ygonb/PIBEX/COBENGE/Imagens/Circuito 2.JPG

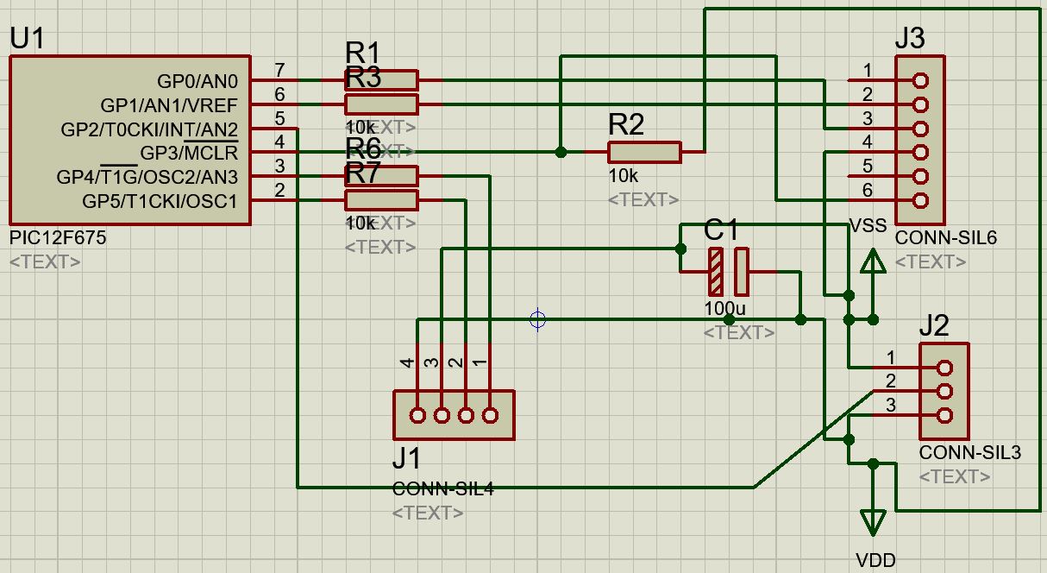
COBENGE/Imagens/Circuito 2.JPG
