ygonb/PIBEX/COBENGE/Imagens/IMG_20191106_175116710.jpg

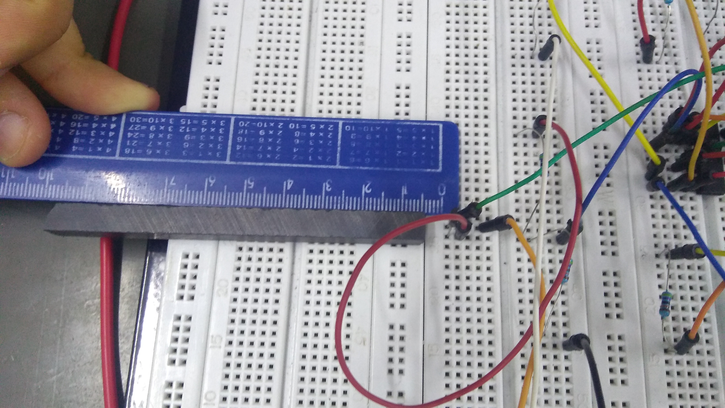
COBENGE/Imagens/IMG_20191106_175116710.jpg
