ygonb/PIBEX/README.md

# PIBEX
Projeto PIBEX 2019-2020

Este repositório contém os arquivos bla bla bla
