ygonb/PIBEX/Relatório Parcial/Vídeo/Decscartados/SLIDE APRESENTAÇÃO PARCIAL.pptx

## Título:


DESENVOLVIMENTO E AVALIAÇÃO DE KIT DIDÁTICO MODULAR PARA ENSINO DE FÍSICA EXPERIMENTAL NO ENSINO MÉDIO E SUPERIOR

Nomes do alunos (as): Pedro Henrique Dules de Lima e Lays Leal Correia

Orientador (a):Ygo Neto Batista

## A relevância e objetivo geral do projeto

- Irei aparecer aqui com o vídeo

## Objetivos propostos

- Irei aparecer aqui com o vídeo

## Slide 4
