ygonb/PIBEX/Relatório Final/Vídeo/autorização de imagem - Lays.pdf

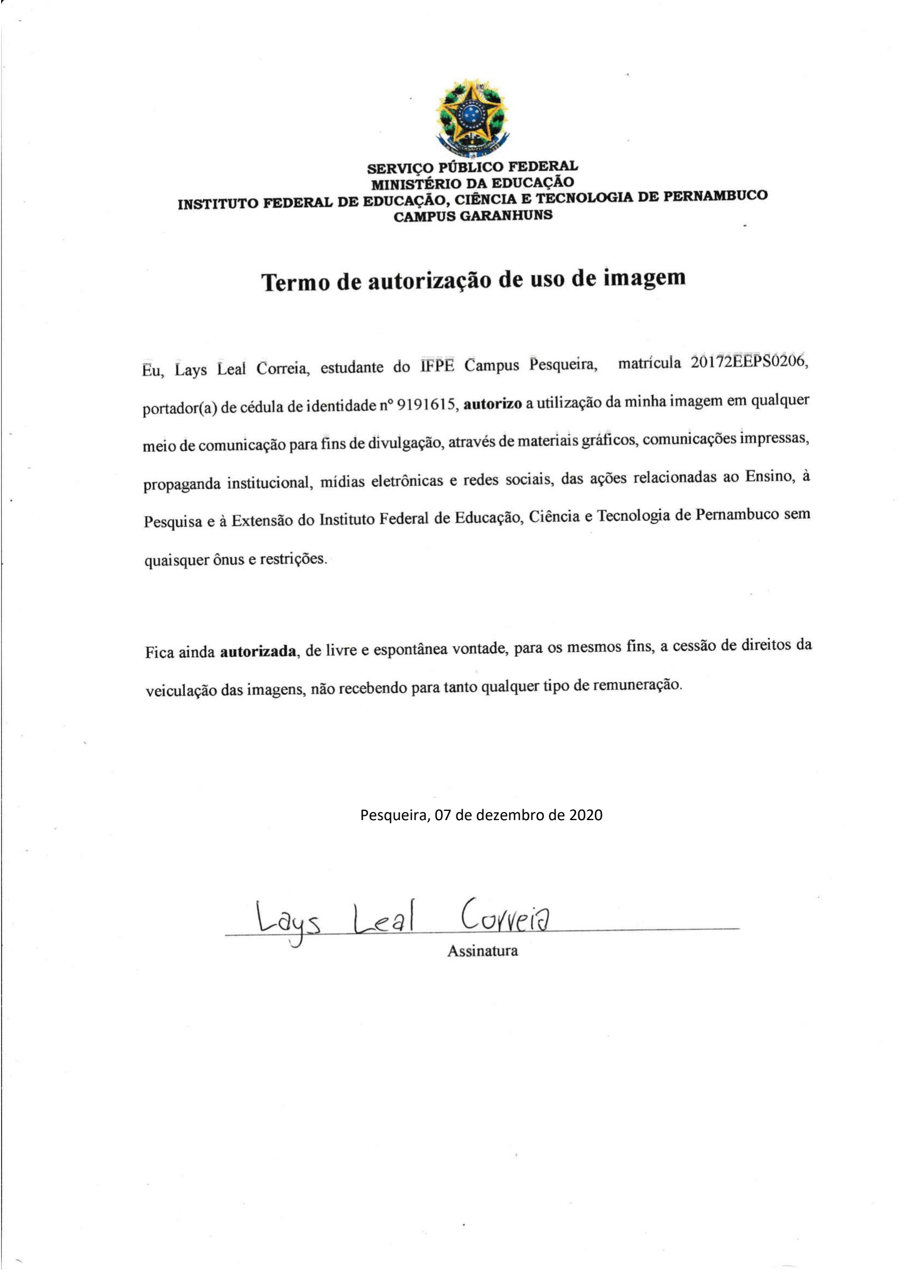
[picture p27: page 1]

Pesqueira, 07 de dezembro de 2020
