ygonb/PIBEX/Circuito Elétrico Inicial/Divisor de tensão.jpeg

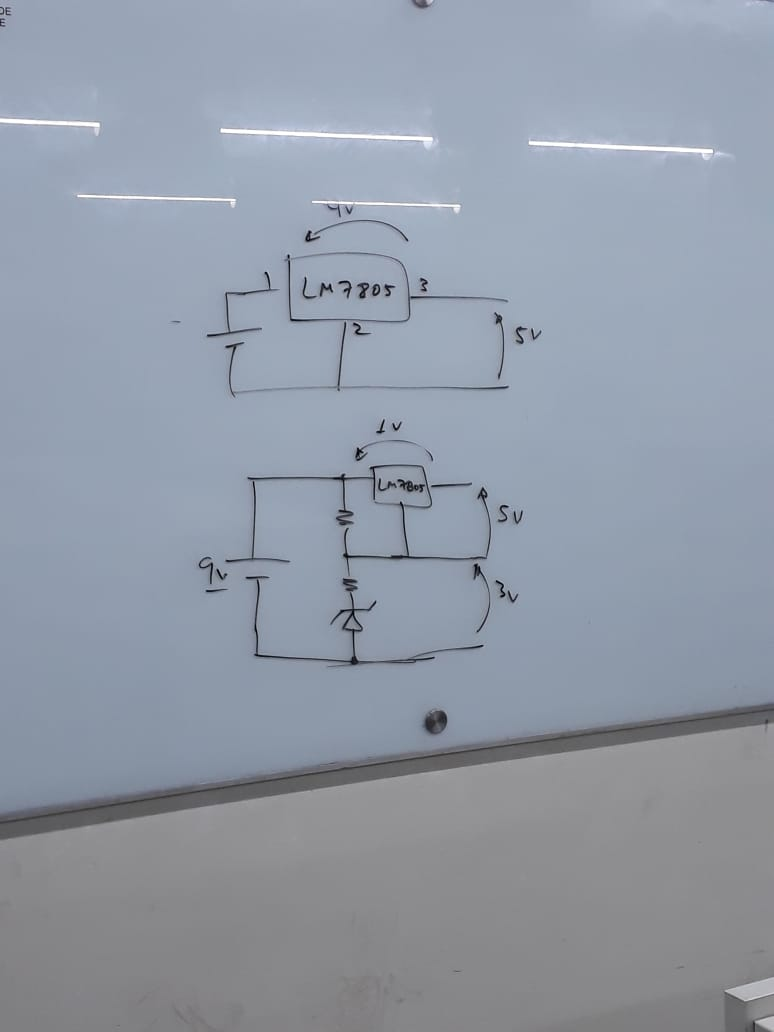
Circuito Elétrico Inicial/Divisor de tensão.jpeg
