ygonb/PIBEX/Circuito Elétrico Inicial/Esboço inicial.jpeg

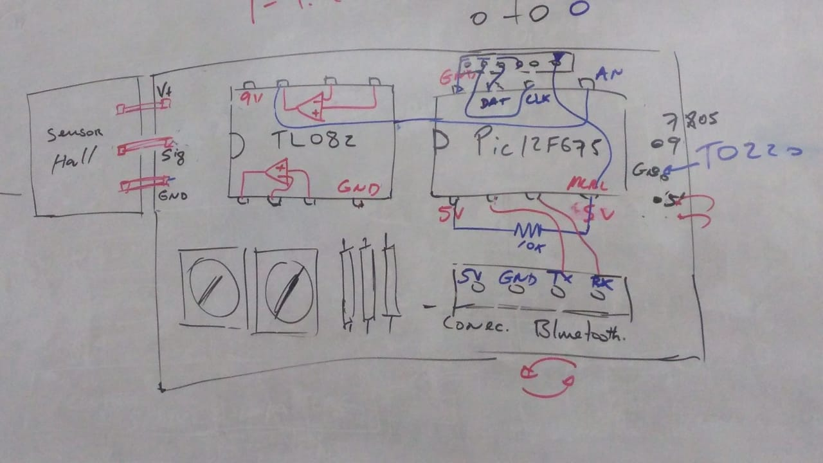
Circuito Elétrico Inicial/Esboço inicial.jpeg
