ygonb/PIBEX/COBENGE/Imagens/IMG_20191106_175142173.jpg

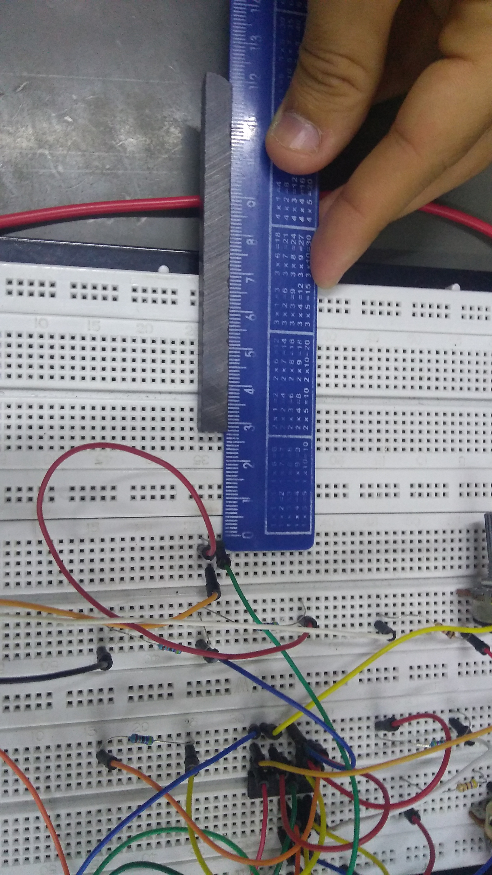
COBENGE/Imagens/IMG_20191106_175142173.jpg
