ygonb/PIBEX/COBENGE/Imagens/IMG_20191106_175145256.jpg

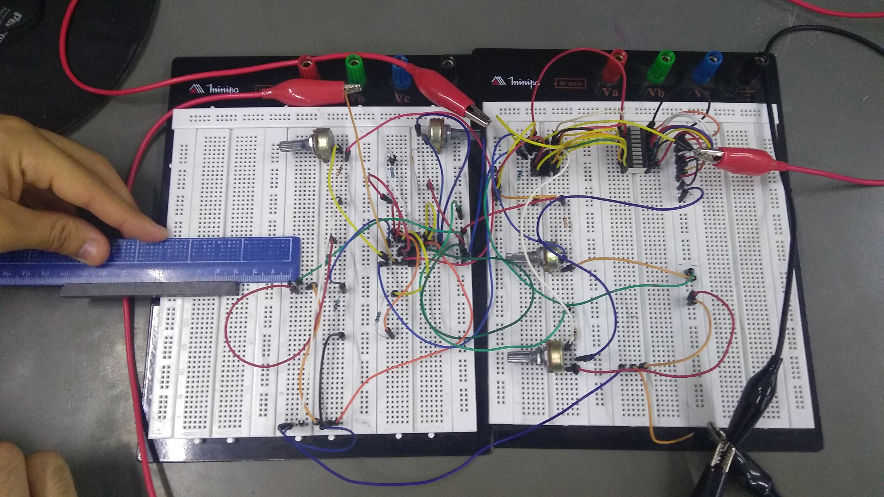
COBENGE/Imagens/IMG_20191106_175145256.jpg
