ygonb/PIBEX/COBENGE/Imagens/PCB 1.JPG

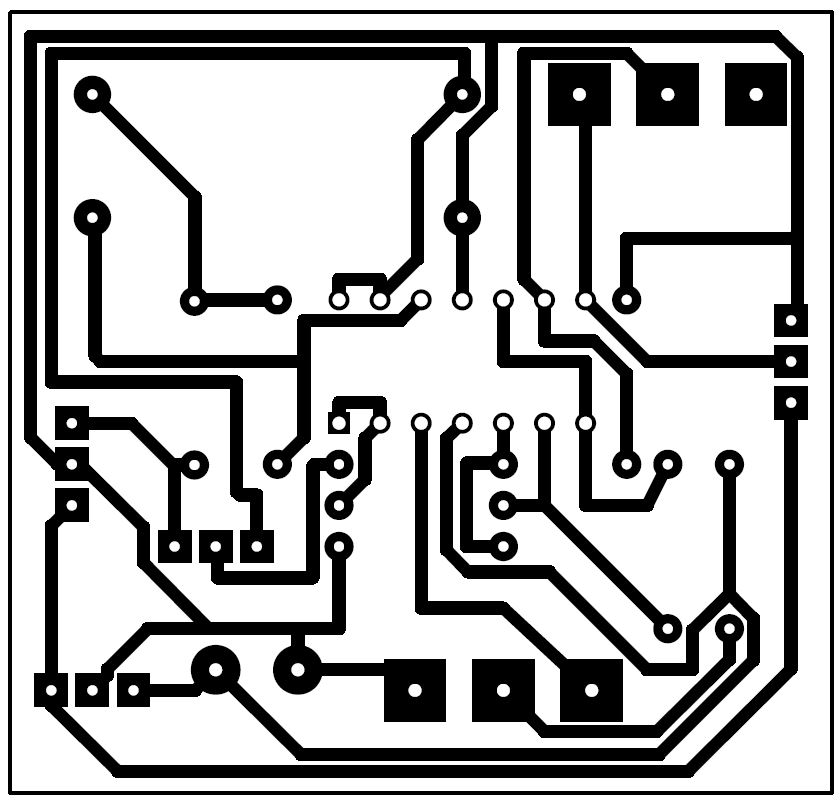
COBENGE/Imagens/PCB 1.JPG
