ygonb/PIBEX/COBENGE/Imagens/PCB 2.JPG

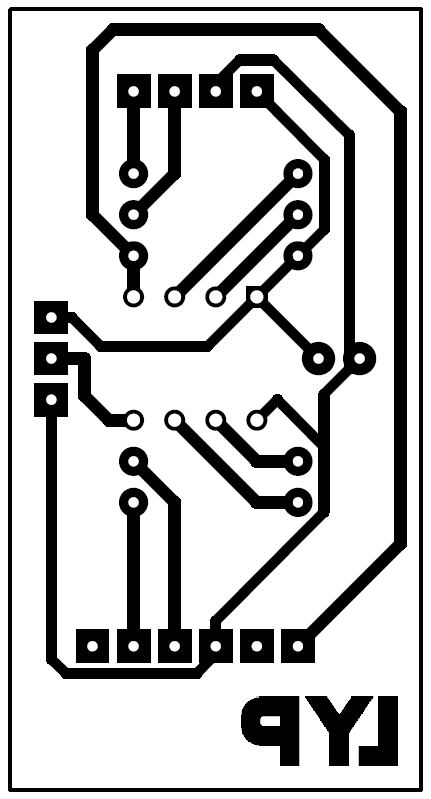
COBENGE/Imagens/PCB 2.JPG
