ygonb/PIBEX/Filtro passa baixa CM.jpeg

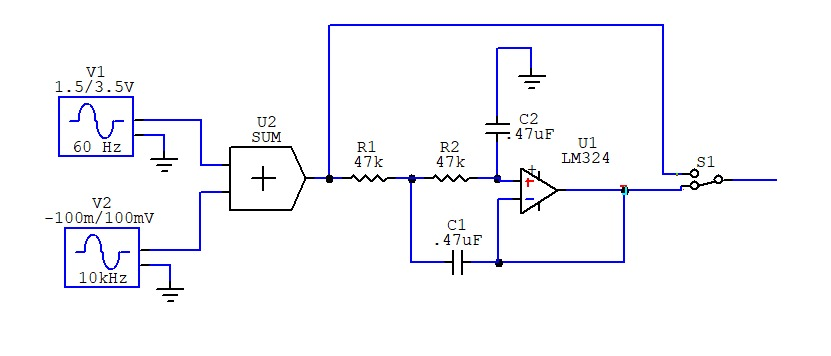
Filtro passa baixa CM.jpeg
