ygonb/PIBEX/Protoboard 1 - Projeto Original.JPG

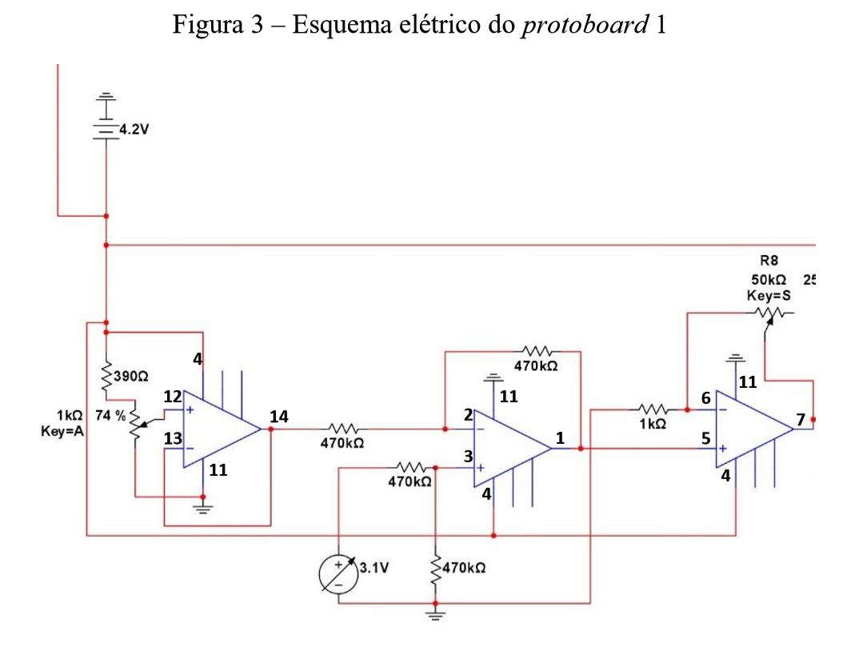
Protoboard 1 - Projeto Original.JPG
