ygonb/PIBEX/Relatório Final/Vídeo/capa.png

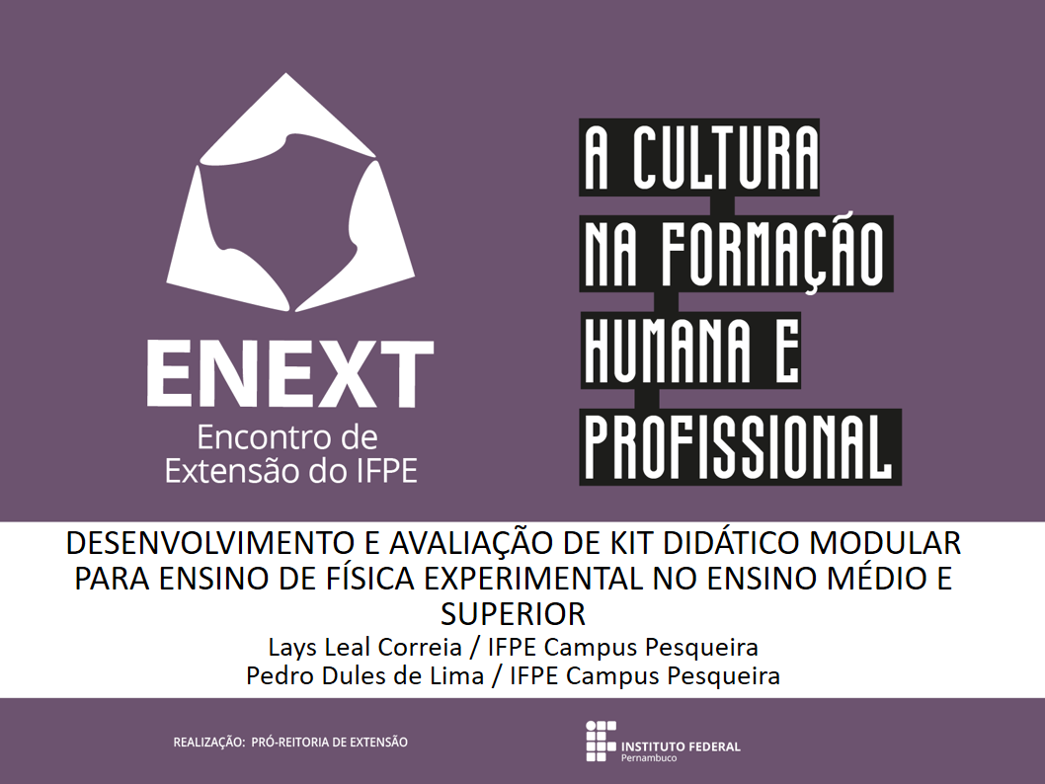
Relatório Final/Vídeo/capa.png
