ygonb/PIBEX/Relatório Final/Vídeo/Circuito Ultrassônico.png

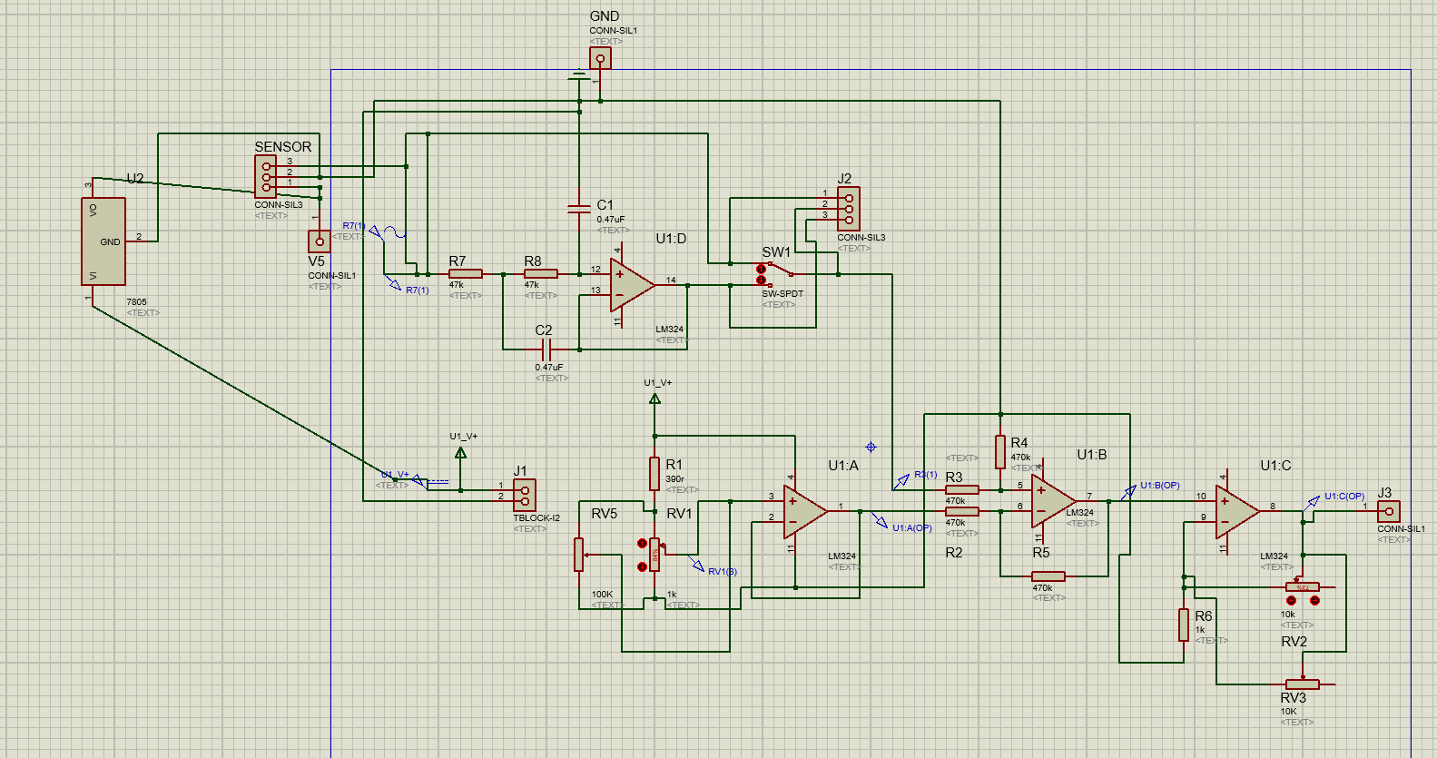
Relatório Final/Vídeo/Circuito Ultrassônico.png
