ygonb/PIBEX/Relatório Final/Vídeo/lives-projeção-enext.png

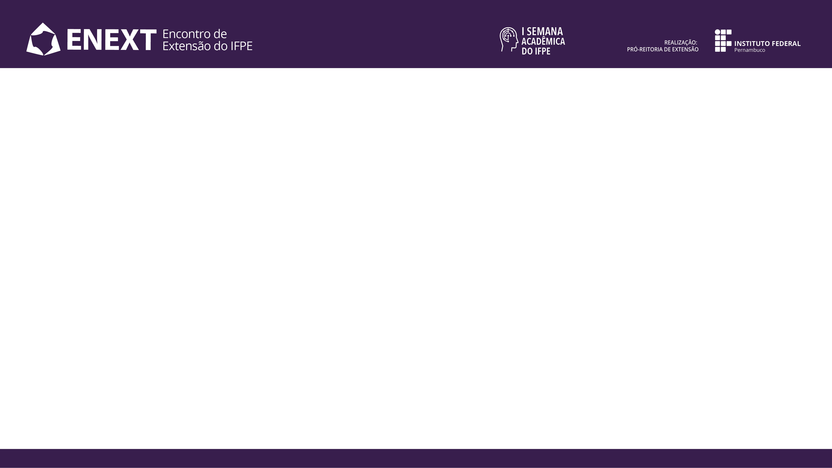
Relatório Final/Vídeo/lives-projeção-enext.png
