ygonb/PIBEX/Relatório Parcial/Vídeo/Slide Lays/Slide1.png

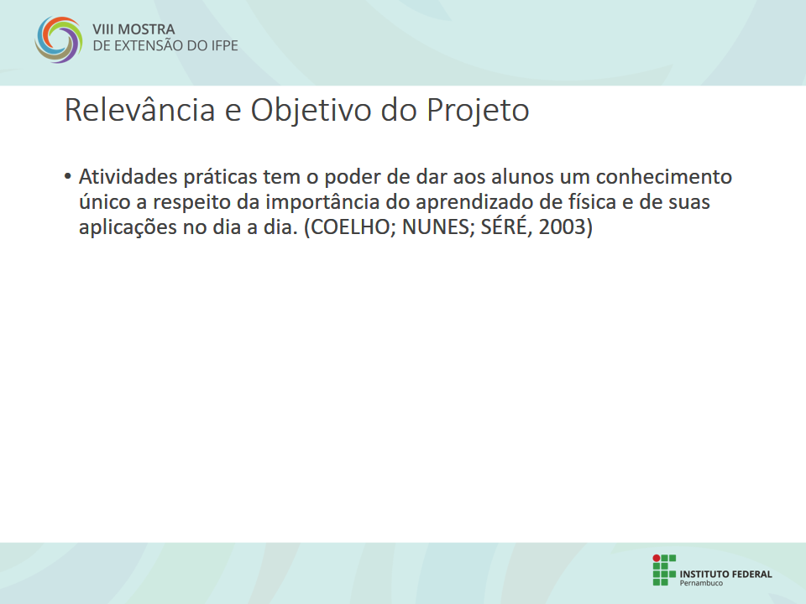
Relatório Parcial/Vídeo/Slide Lays/Slide1.png
