ygonb/PIBEX/Relatório Parcial/Vídeo/Slide Lays/Slide2.png

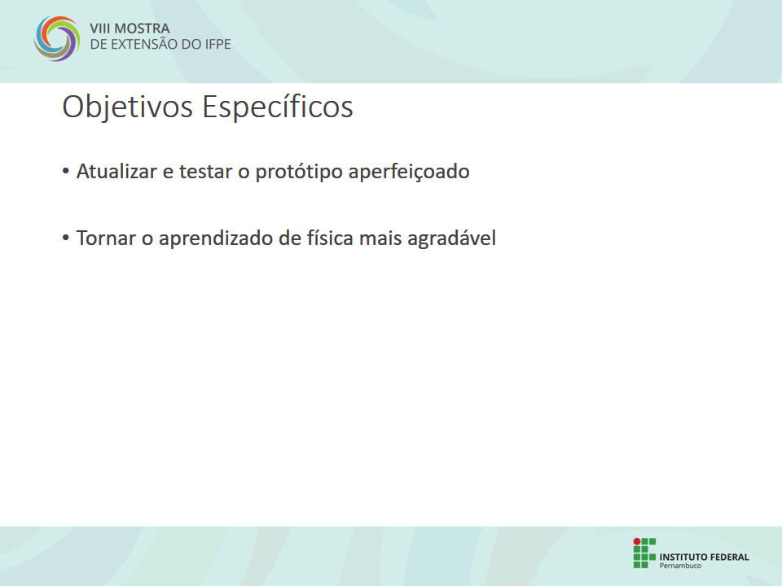
Relatório Parcial/Vídeo/Slide Lays/Slide2.png
