ygonb/PIBEX/Relatório Parcial/Vídeo/Slide Lays/Slide3.PNG

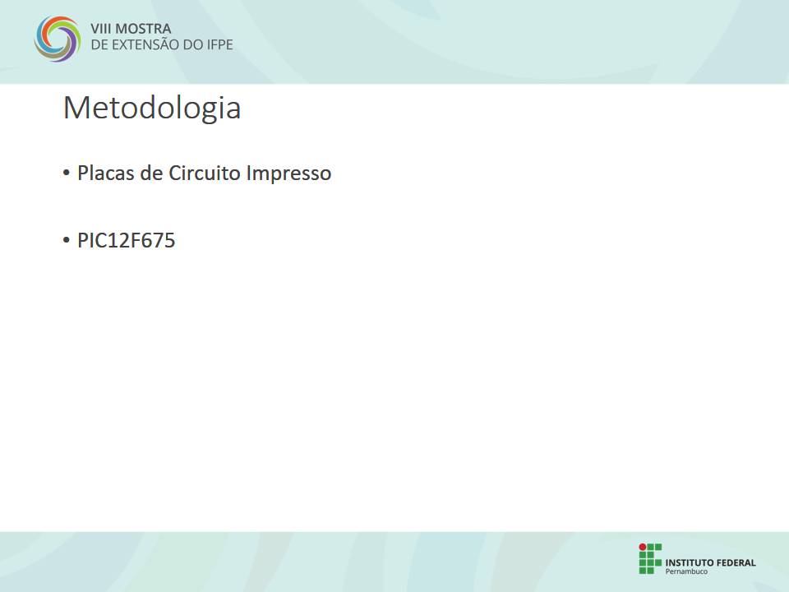
Relatório Parcial/Vídeo/Slide Lays/Slide3.PNG
