ygonb/PIBEX/Relatório Parcial/Vídeo/Slide Lays/Slide4.PNG

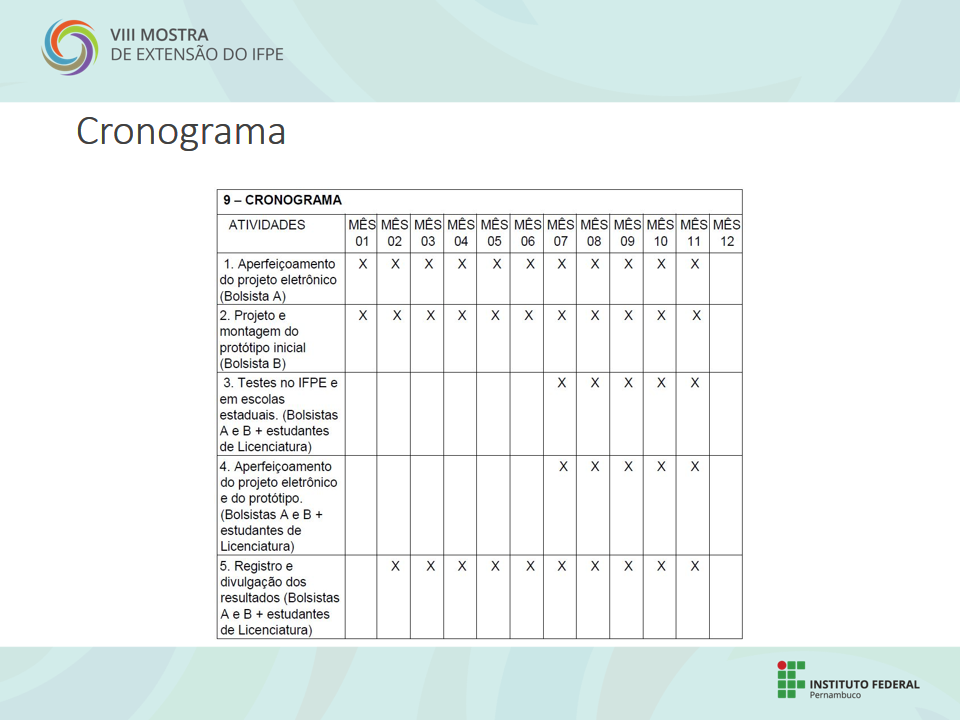
Relatório Parcial/Vídeo/Slide Lays/Slide4.PNG
