ygonb/PIBEX/Relatório Parcial/Vídeo/Slide Lays/Slide5.PNG

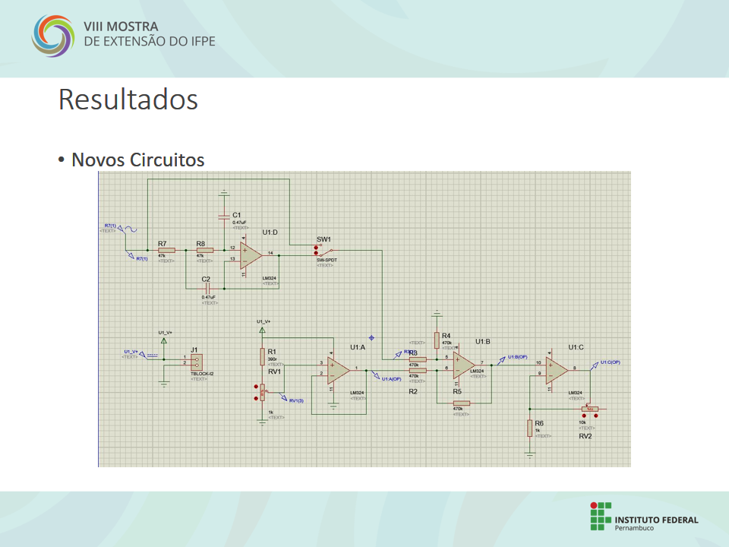
Relatório Parcial/Vídeo/Slide Lays/Slide5.PNG
