ygonb/PIBEX/Relatório Parcial/Vídeo/Slide Lays/Slide6.PNG

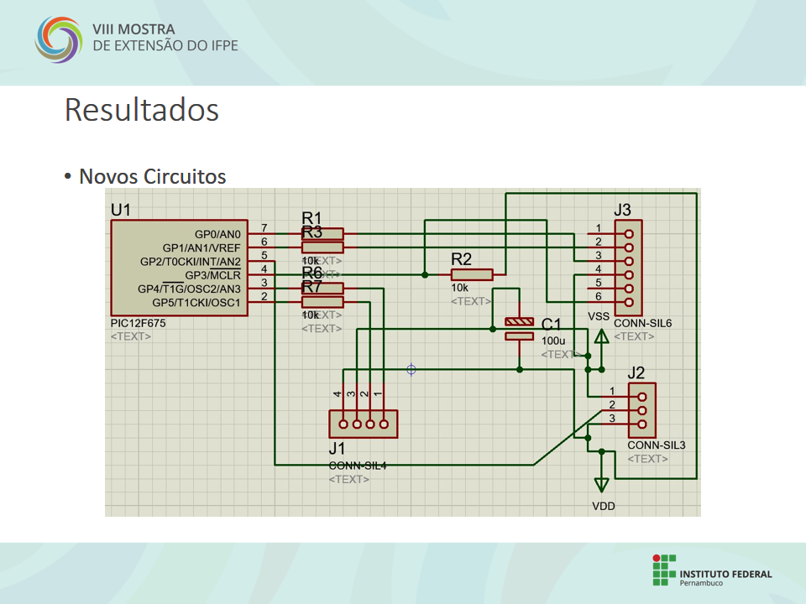
Relatório Parcial/Vídeo/Slide Lays/Slide6.PNG
