ygonb/PIBEX/Relatório Parcial/Vídeo/Slide Lays/Slide7.PNG

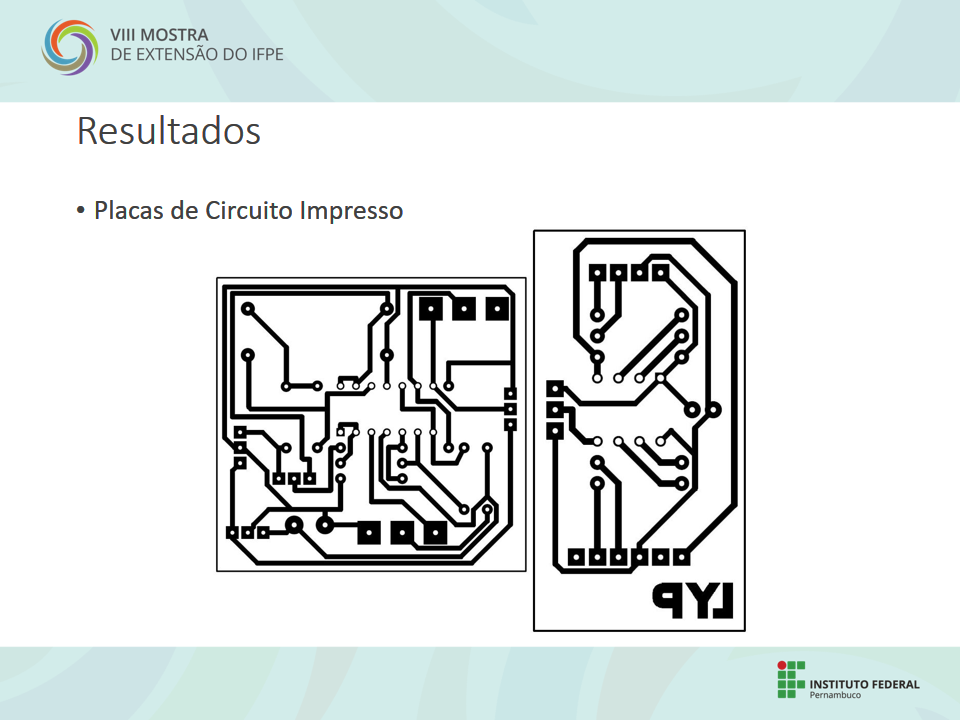
Relatório Parcial/Vídeo/Slide Lays/Slide7.PNG
