ygonb/PIBEX/Relatório Parcial/Vídeo/Slide Lays/Slide8.PNG

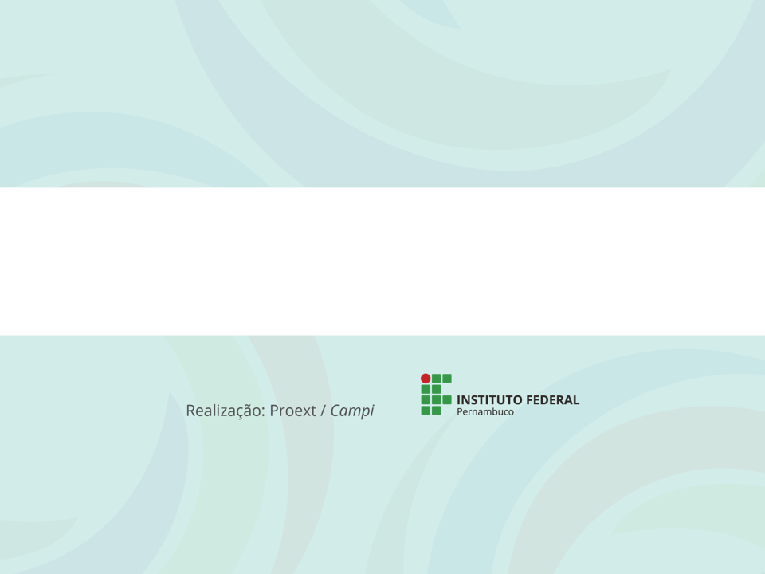
Relatório Parcial/Vídeo/Slide Lays/Slide8.PNG
