ygonb/PIBEX/Relatório Parcial/Vídeo/Slide Lays/Slide9.png

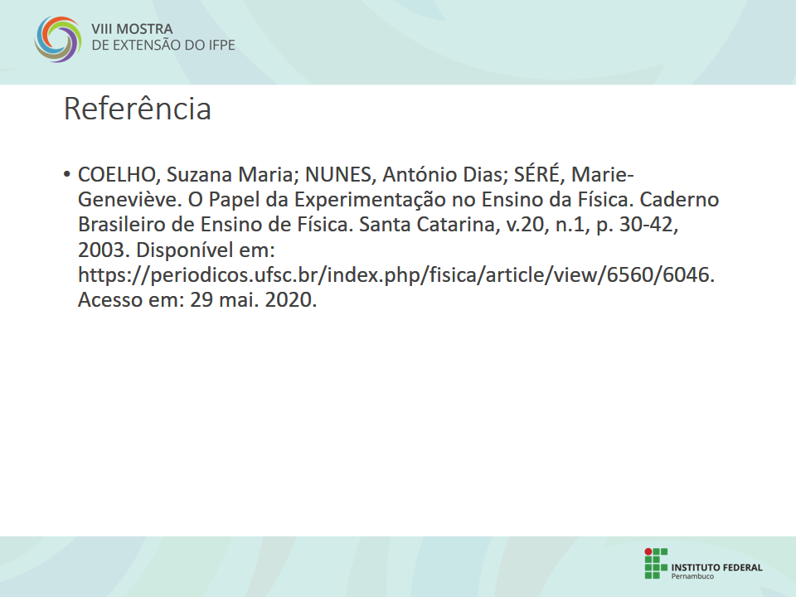
Relatório Parcial/Vídeo/Slide Lays/Slide9.png
