ygonb/PIBEX/Relatório Parcial/Vídeo/Slide Lays/Slide21.png

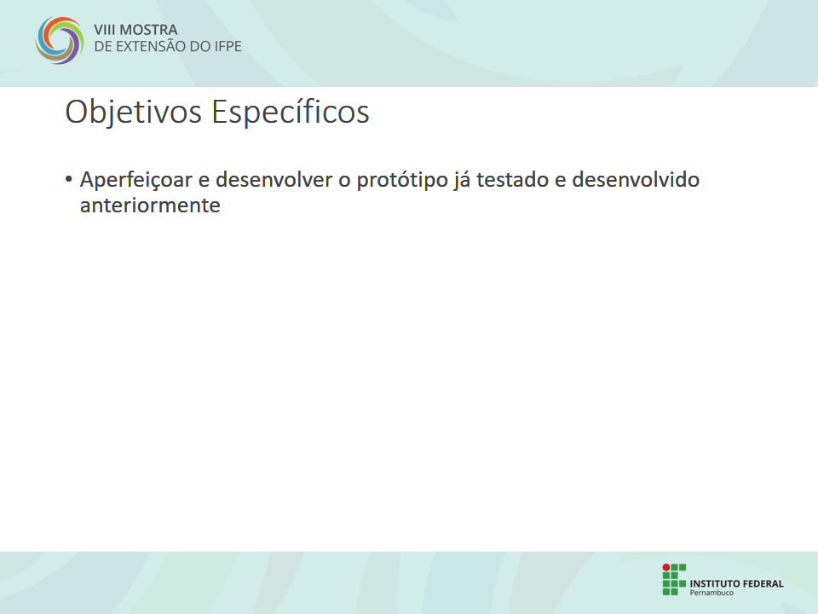
Relatório Parcial/Vídeo/Slide Lays/Slide21.png
