ygonb/PIBEX/Relatório Parcial/Vídeo/Slide Lays/Slide Lays.png

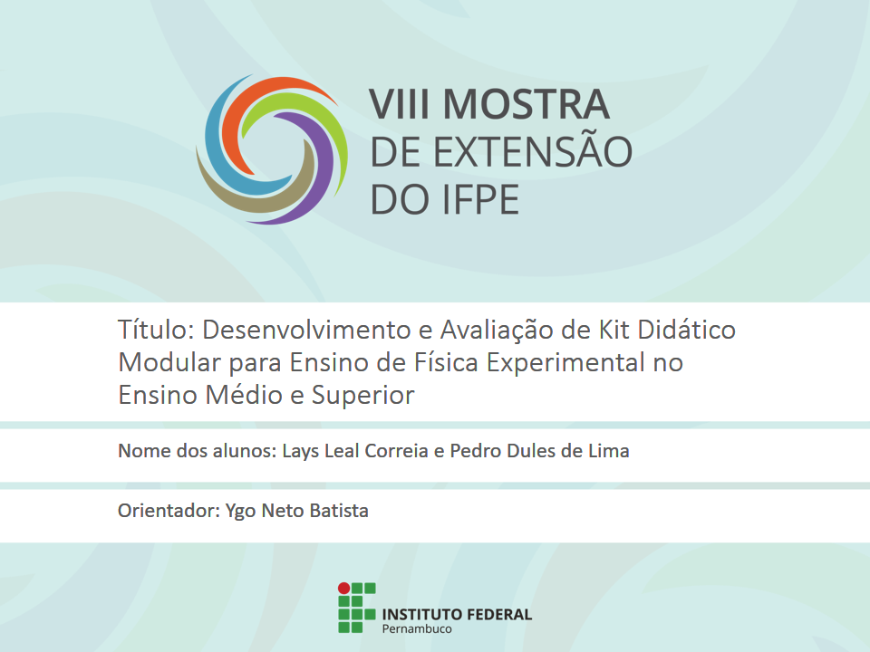
Relatório Parcial/Vídeo/Slide Lays/Slide Lays.png
