ygonb/PIBEX/PCB/PCB2 v1.pdf

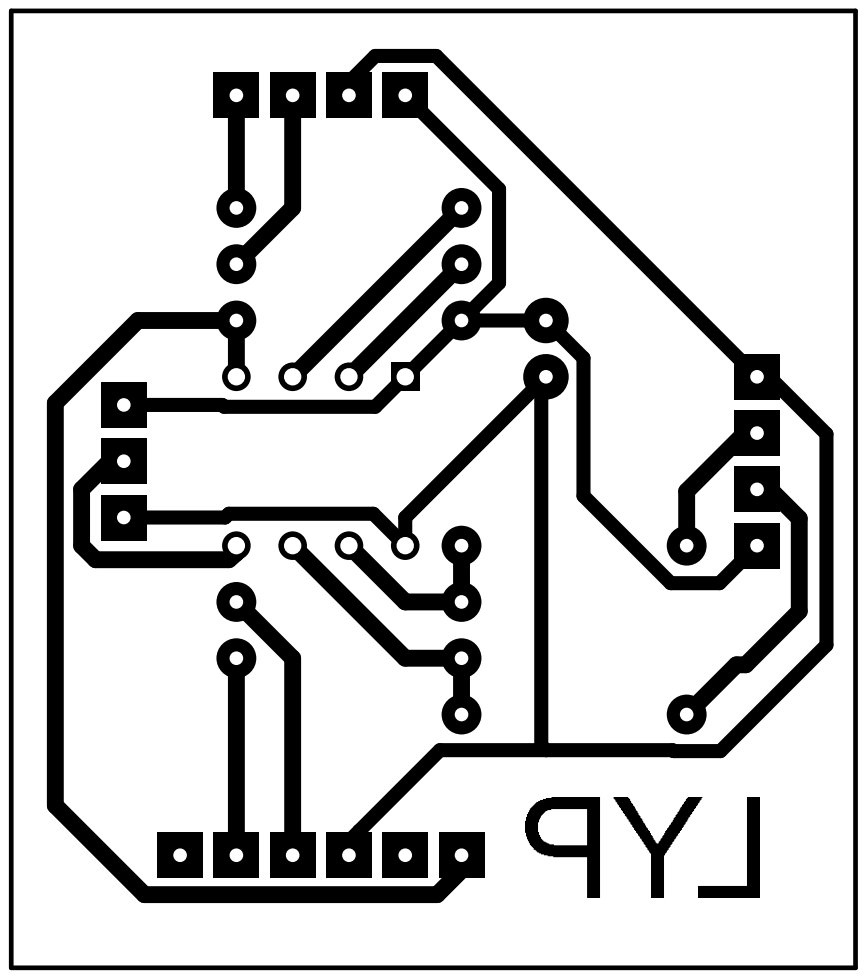
[picture p50: page 1]
