ygonb/PIBEX/PCB/PCB1 v1.pdf

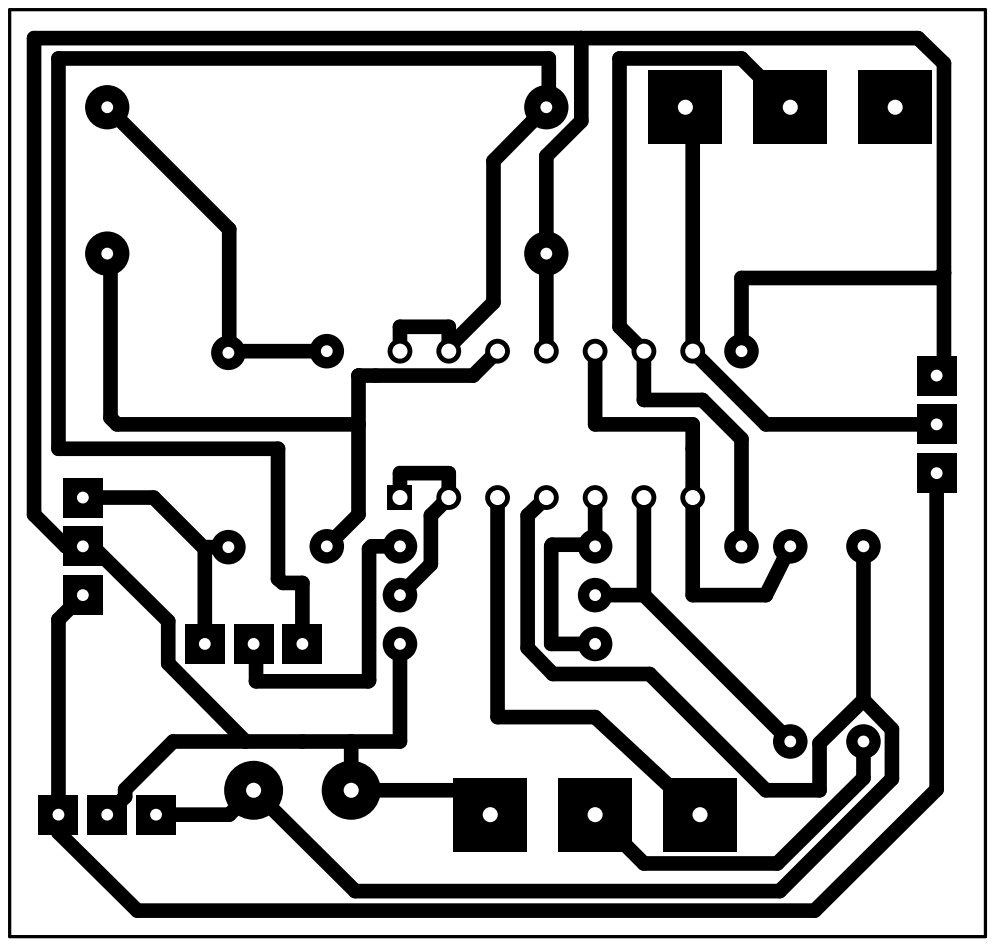
[picture p51: page 1]
