ygonb/PIBEX/(list of files, drawings)

Other design files:
adc e trans. serial (Proteus)/adc.pdsprj
adc e trans. serial (Proteus)/New Project.pdsprj
adc e trans. serial/adc.pdsprj
adc e trans. serial/New Project.pdsprj
Circuito Elétrico Inicial/CIRCUITO INICIAL PCB.pdsprj
Circuito Elétrico Inicial/CIRCUITO INICIAL v2.pdsprj
Circuito Elétrico Inicial/CIRCUITO INICIAL.pdsprj
Circuito Novo/PIBEX.pdsprj
Circuito Ultrassônico/PIBEX novo.pdsprj
Circuito Ultrassônico/PIBEX.pdsprj
