ygonb/PIBEX/(commit log)

2020-03-19 Atualização das instruções para uso do GitHub
    Adicionado linha de cabeçalho
2020-03-19 Criação dos arquivos do projeto
    Arquivos do circuito elétrico (design e PCB) do projeto PIBEX implementado em Proteus 8.1
    [New Project.pdsprj]
2020-03-19 Testes com o GitHub
    Inserido um resistor e alterado o nome do arquivo
    [PIBEX.pdsprj]
2020-03-19 teste do github
    [PIBEX.pdsprj]
2020-03-19 Apresentação do Proteus
    Teste de elaboração de PCB e Simulação
    [PIBEX.pdsprj]
2020-03-19 Esboço inicial
    Esboço do projeto desenvolvido em 11 de março de 2020
2020-03-22 Adicionado artigo do projeto e foto do desenho de Ygo
2020-03-22 circuito inicial do sensor hall, até a pinagem de saída do amplificador
    [CIRCUITO INICIAL.pdsprj]
2020-03-24 atualização do circuito
    [CIRCUITO INICIAL.pdsprj]
2020-03-26 Revisão do circuito inicial
    Revisão dos circuitos de buffer para a tensão de referência do subtrator, do subtrator e do amplificador não inversor. Testes de simulação no Proteus. Simulação do filtro ativo da entrada.
    [CIRCUITO INICIAL v2.pdsprj]
2020-03-26 Envio de .HEX (aleatório) para testes
2020-03-27 Embelezamento do circuito, adição de datasheet e imagem do circuito original
    O circuito foi visualmente simplificado e algumas conexões foram corrigidas, as tensões agora são similares ao testado na prática.
    O datasheet do sensor foi adicionado a pasta.
    Imagem do circuito do protoboard 1 foi adicionado a pasta, servindo de fácil referência.
    [CIRCUITO INICIAL.pdsprj]
2020-03-27 Embelezamento do circuito, adição de datasheet e imagem do circuito original adicionada
    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
2020-03-28 Adição do filtro ao circuito
    filtro passa baixa
    [CIRCUITO INICIAL.pdsprj]
2020-03-31 Atualização na simulação da parte analógica
    Testes e atualização no esquemático da parte analógica
    [CIRCUITO INICIAL PCB.pdsprj, CIRCUITO INICIAL.pdsprj]
2020-04-04 Versão 1 da PCB 1
    [CIRCUITO INICIAL PCB.pdsprj]
2020-04-06 pcb melhoramento inicial
    [CIRCUITO INICIAL PCB.pdsprj]
2020-04-06 Melhorias no circuito da PCB
    [CIRCUITO INICIAL PCB.pdsprj]
2020-04-07 Atualizações da PCB
    [CIRCUITO INICIAL PCB.pdsprj]
2020-04-07 Ajustes na PBC
    [CIRCUITO INICIAL PCB.pdsprj]
2020-04-08 Ajuste de GND, VCC e J3
    [CIRCUITO INICIAL PCB.pdsprj]
2020-04-09 Simulação e PCB da placa 2
    [CIRCUITO INICIAL PCB.pdsprj, CIRCUITO INICIAL v2.pdsprj, CIRCUITO INICIAL.pdsprj, PIBEX.pdsprj]
2020-04-16 Versão final das PCBs
    [CIRCUITO INICIAL PCB.pdsprj, PIBEX.pdsprj]
2020-06-13 vídeo
    [PIBEX.pdsprj]
2020-07-07 adc e transmissão serial simulação
    [New Project.pdsprj, adc.pdsprj]
2020-09-16 início das atividades com o sensor ultrassônico
2020-09-29 adição do novo sensor ao circuito
    [PIBEX.pdsprj]
2020-11-04 Circuito novo
    [PIBEX.pdsprj]
2020-11-13 Finalização da PCB 2
    [PIBEX novo.pdsprj, PIBEX.pdsprj]
